LZ1DPN/CWTRX0to50MHz-v1/arduino uno.jpg

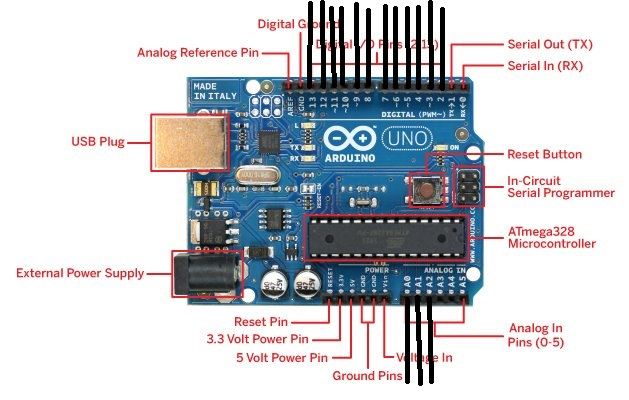
arduino uno.jpg
