LZ1DPN/CWTRX0to50MHz-v1/forty-9er.pdf

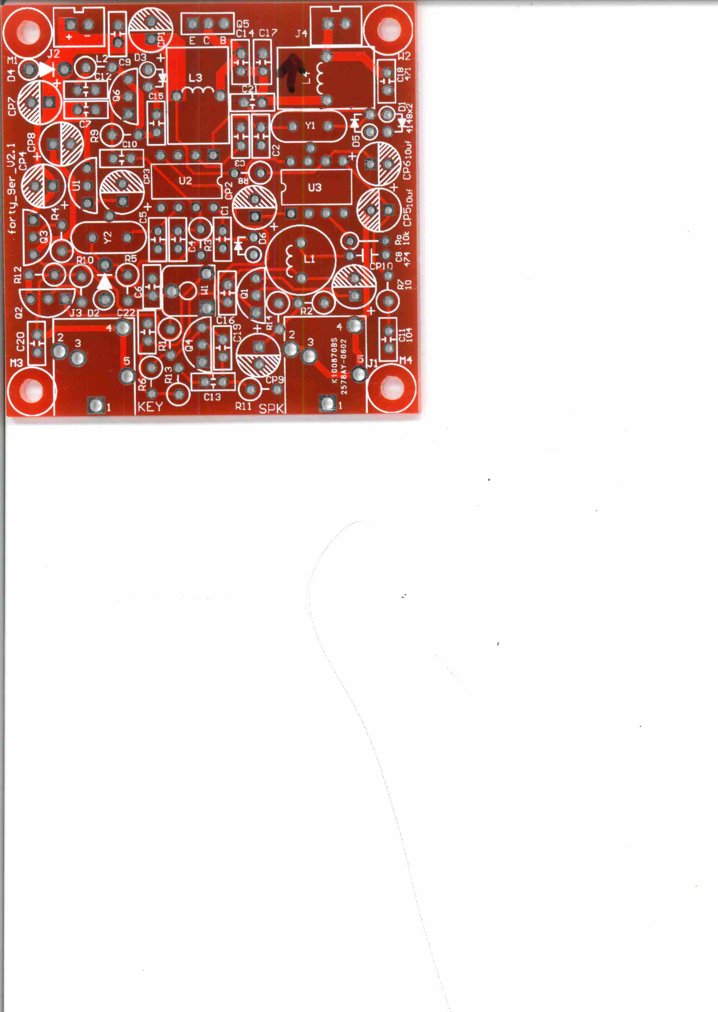
[picture p7: page 1]
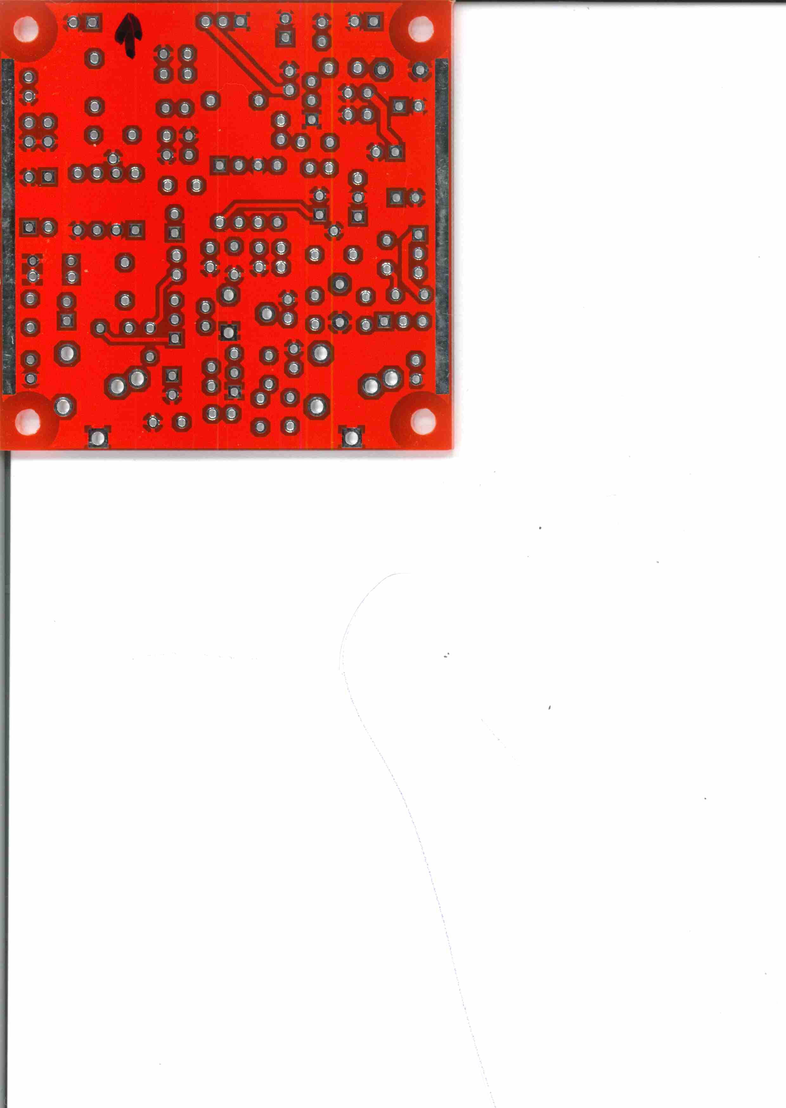
[picture p8: page 2]
