LZ1DPN/CWTRX0to50MHz-v1/74dB_Gain_with_LM386_JF1OZL.gif

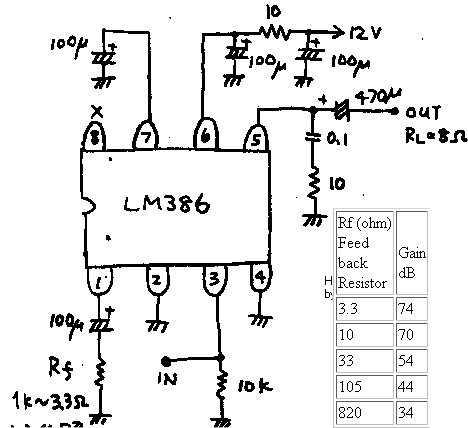
74dB_Gain_with_LM386_JF1OZL.gif
