LZ1DPN/CWTRX0to50MHz-v1/circuitDDS-Arduino-AD-LCD.png

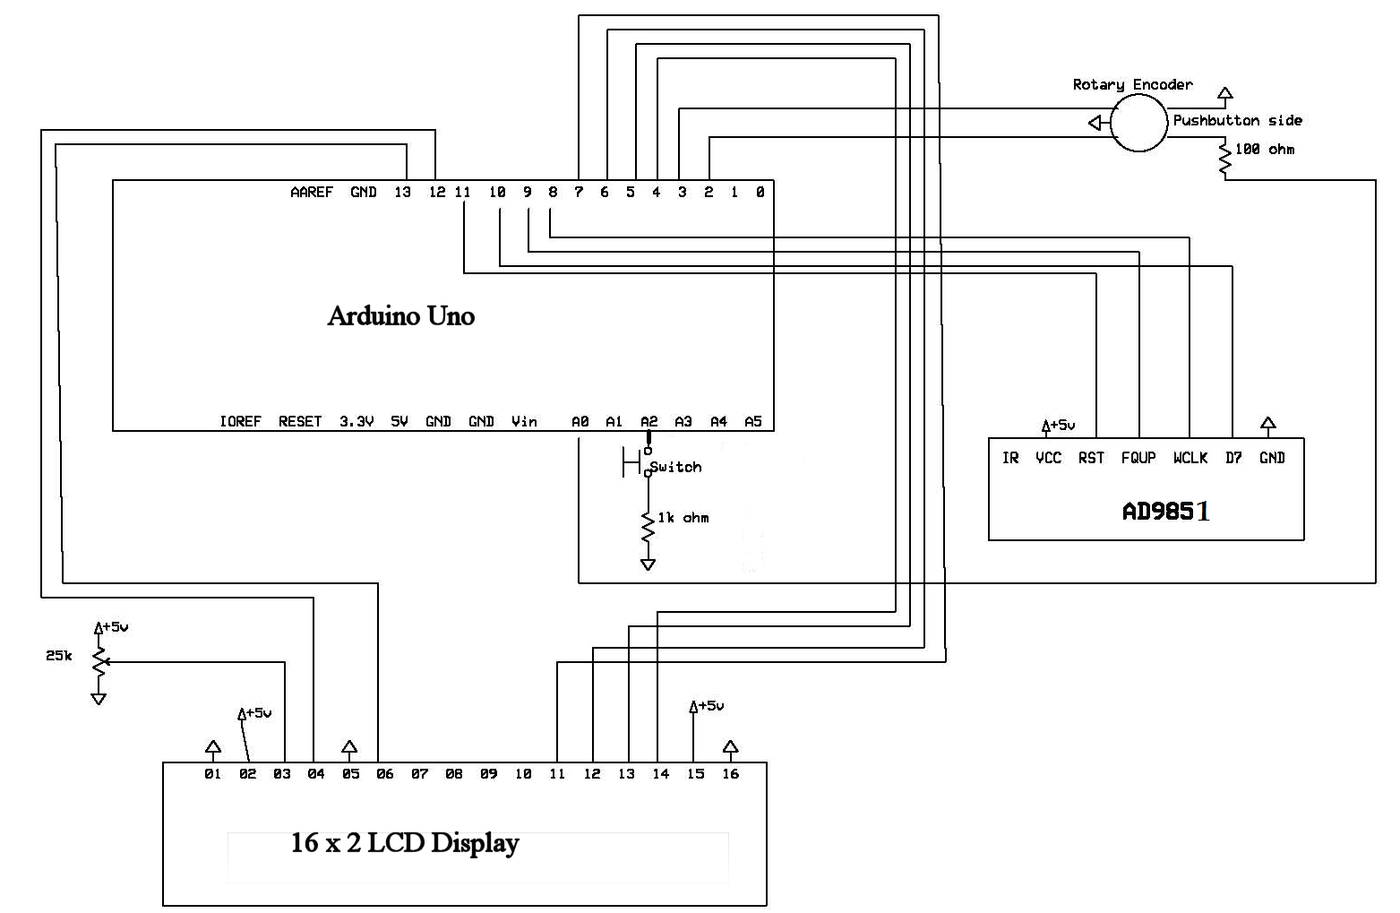
circuitDDS-Arduino-AD-LCD.png
