LZ1DPN/CWTRX0to50MHz-v1/dc-receiver-last.png

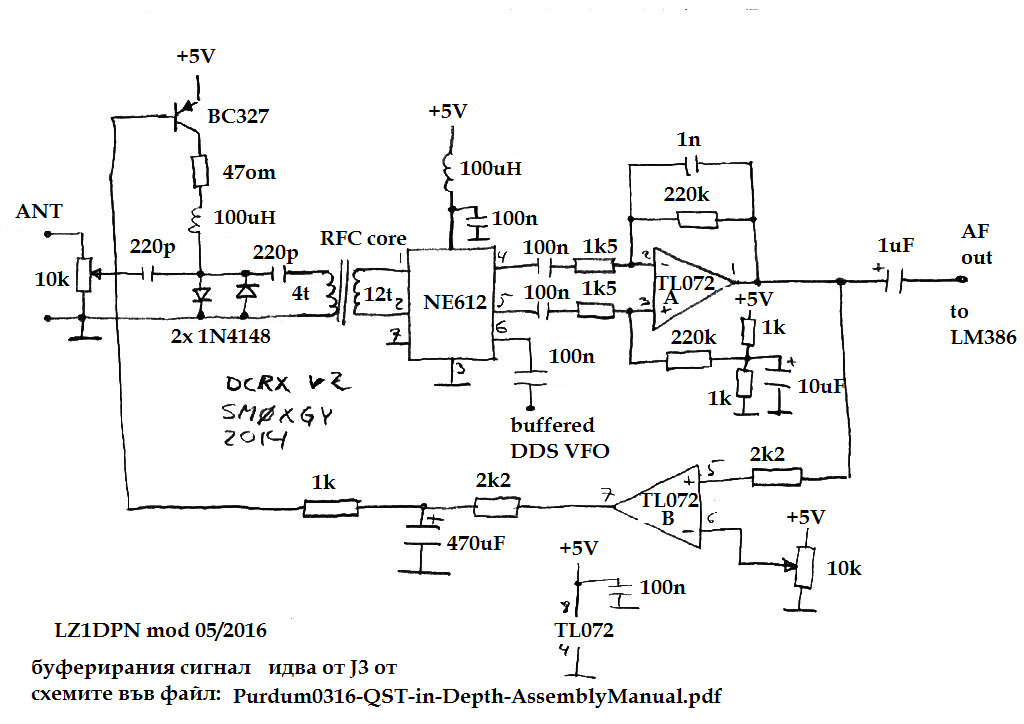
dc-receiver-last.png
