LZ1DPN/CWTRX0to50MHz-v1/dcrx_rf_sch.jpg

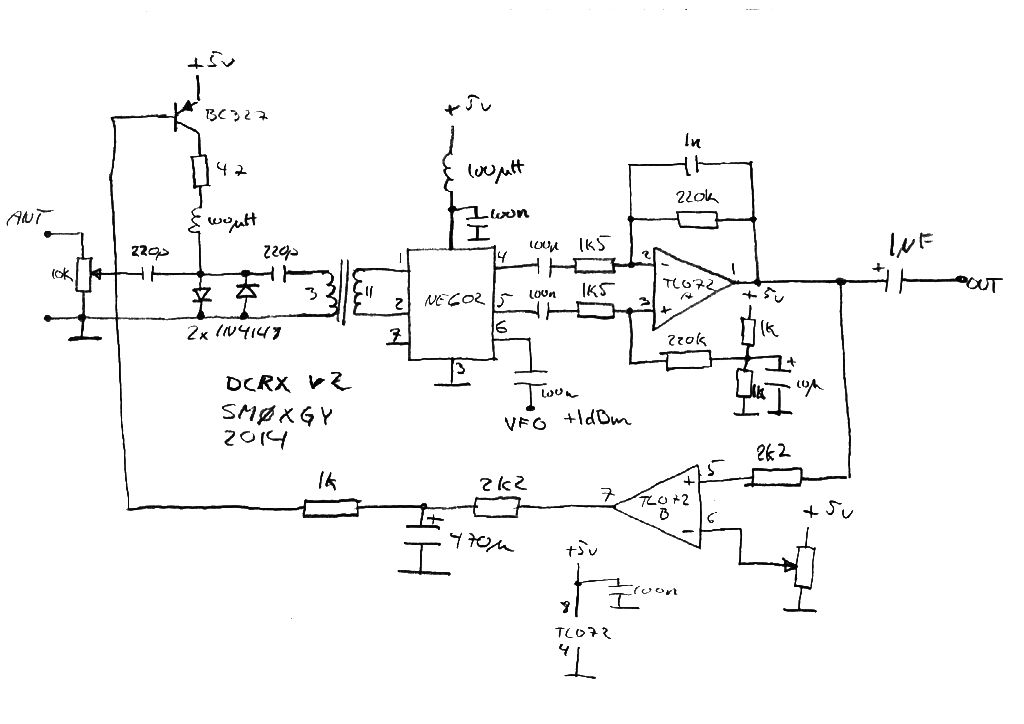
dcrx_rf_sch.jpg
