LZ1DPN/CWTRX0to50MHz-v1/DDSbuffer-and-PowerSupplay.png

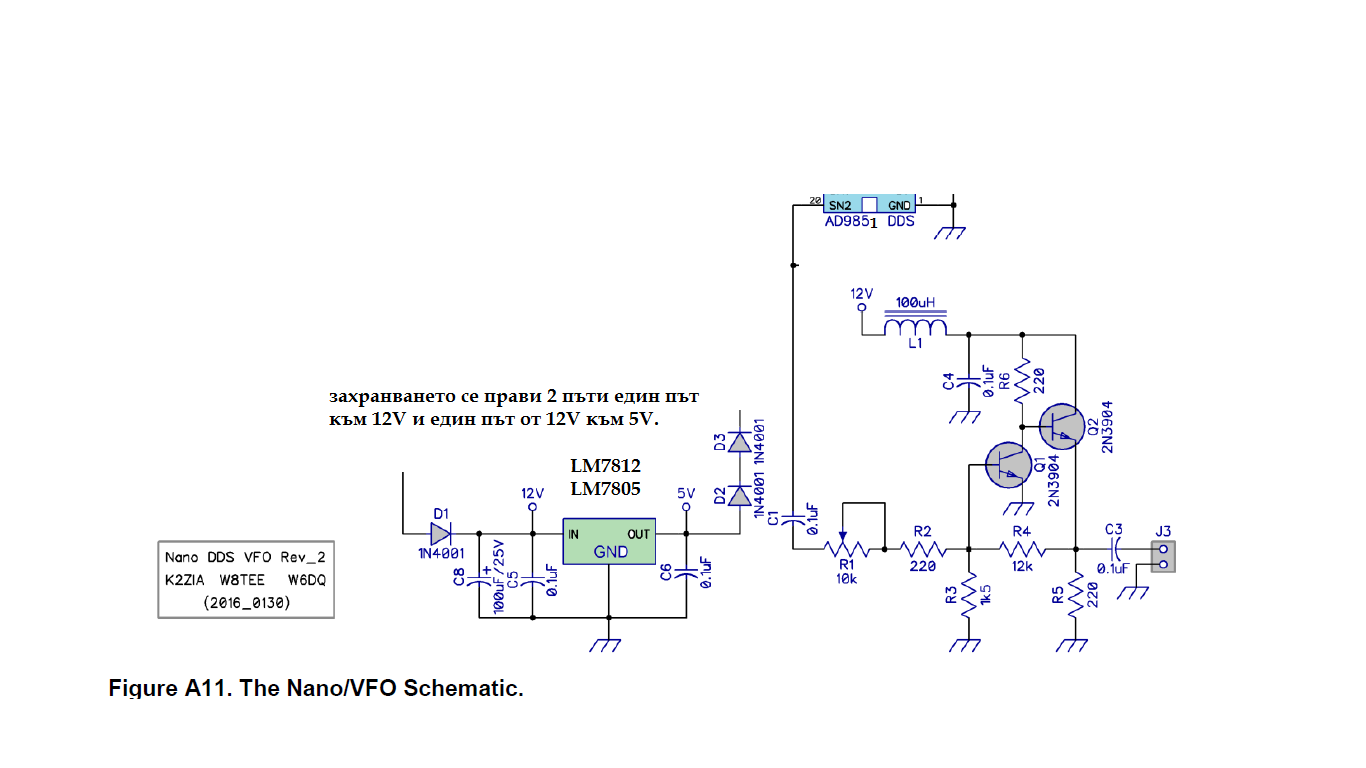
DDSbuffer-and-PowerSupplay.png
