LZ1DPN/CWTRX0to50MHz-v1/LM386ampschematicfinal1.jpg

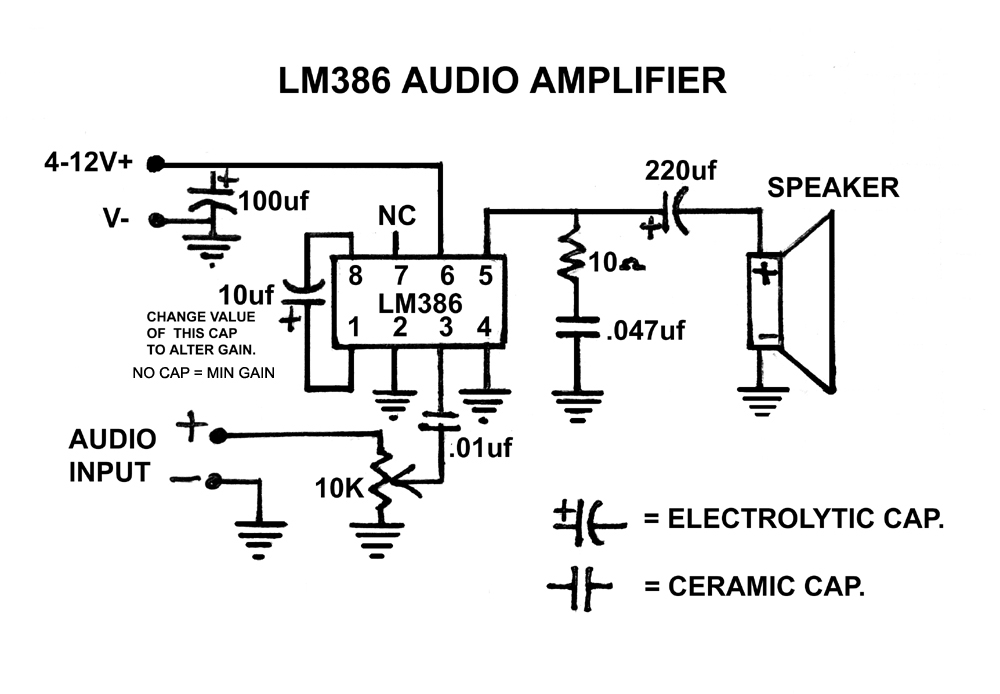
LM386ampschematicfinal1.jpg
