LZ1DPN/CWTRX0to50MHz-v1/relay-control.png

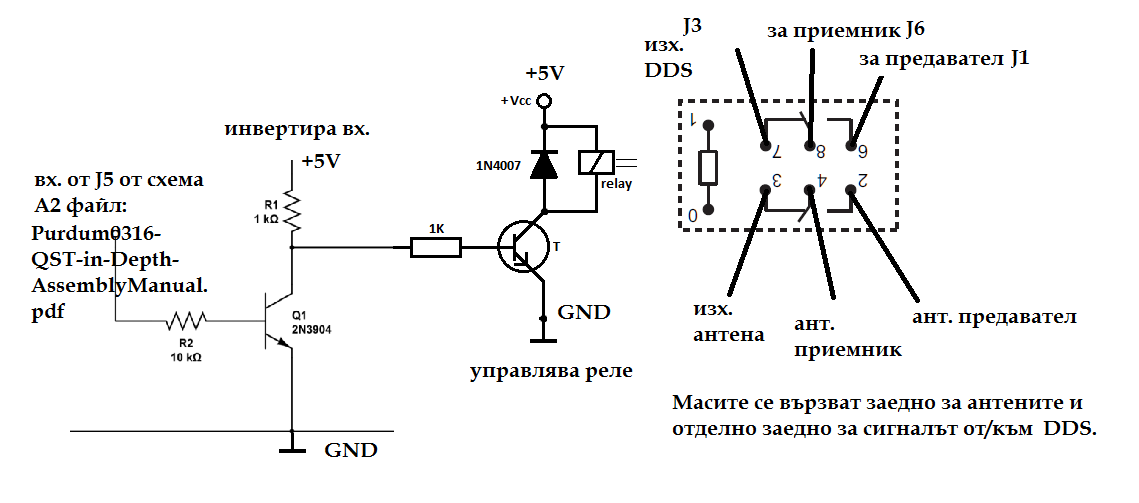
relay-control.png
