LZ1DPN/CWTRX0to50MHz-v1/dds-vfo-assembly-manual-rev2.pdf

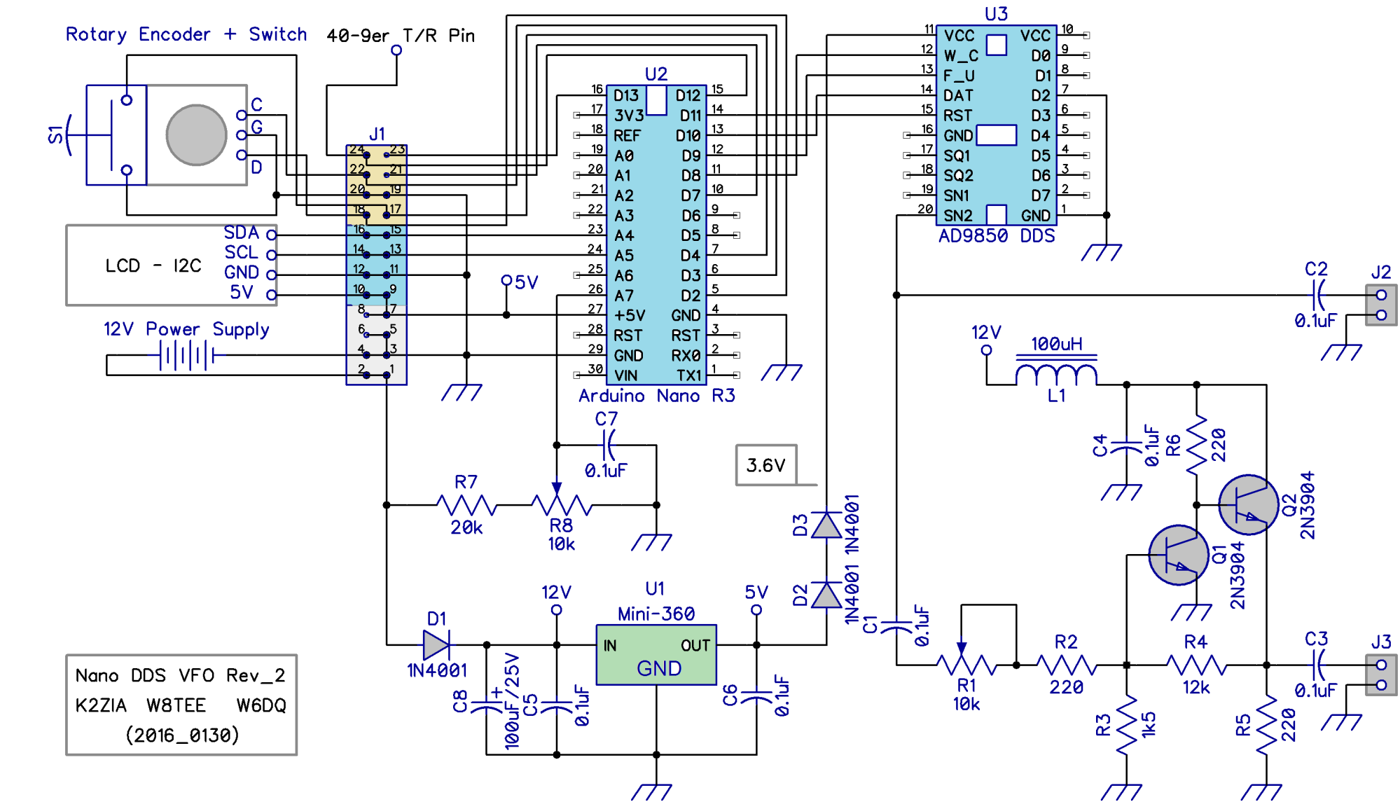
[picture p17: page 1]

Nano DDS VFO Rev_2 Assembly Manual
Farrukh Zia, K2ZIA, 2016_0130
Featured in ARRL QST March 2016 Issue
Nano DDS VFO is a modification of the original VFO design in Arduino™ Projects for Amateur Radio by Dr. Jack Purdum and Dennis Kidder

Schematic Diagram:

R2,R3,R4,R7 are ¼ Watt; R5,R6 are 220 Ohm ½ Watt (or two 470 Ohm ¼ Watt in parallel)

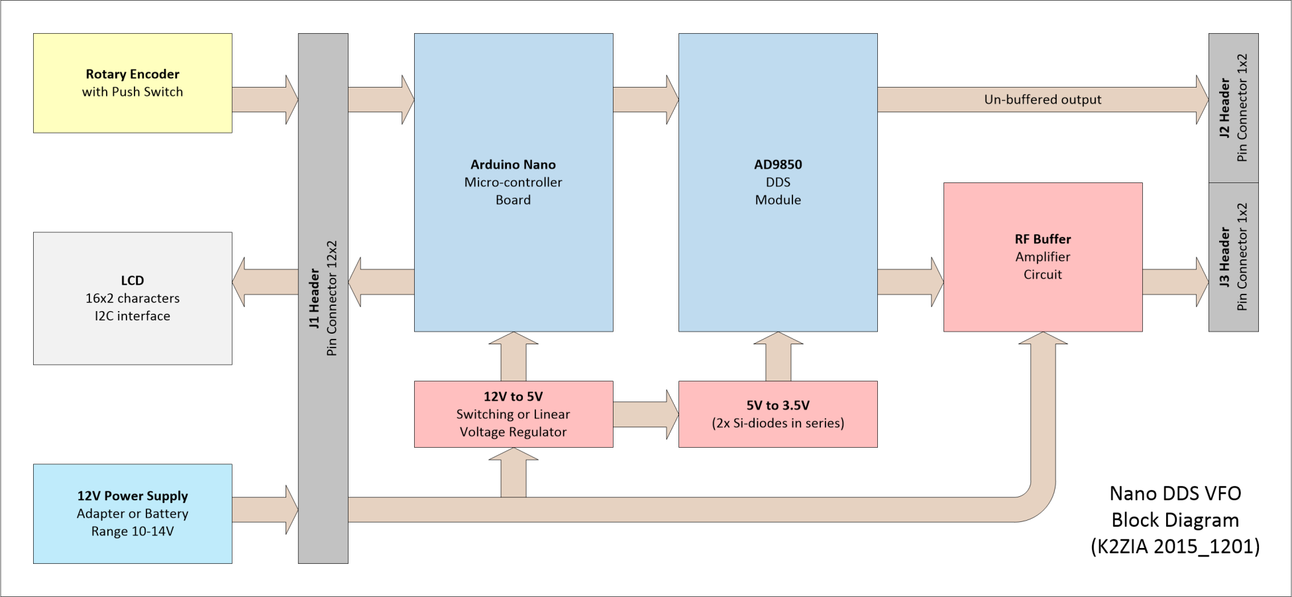
[picture p18: figure]
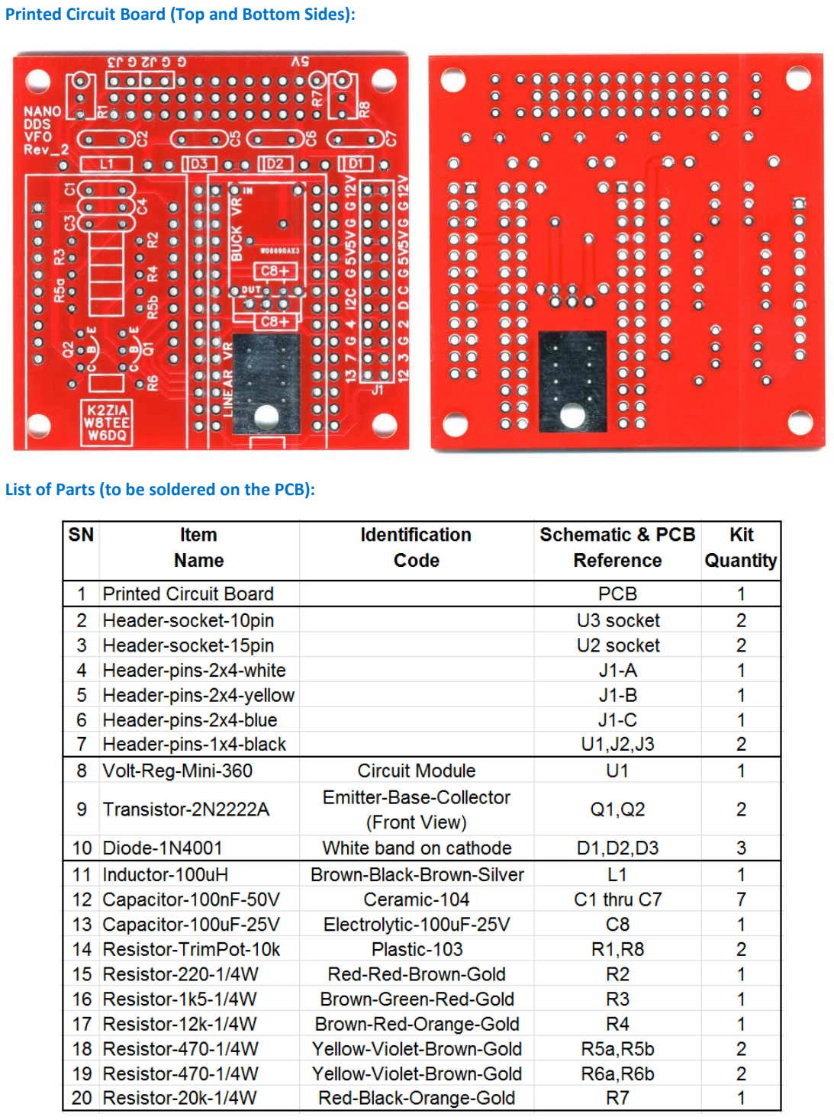
[picture p19: page 3]

Printed Circuit Board (Top and Bottom Sides):

List of Parts (to be soldered on the PCB):

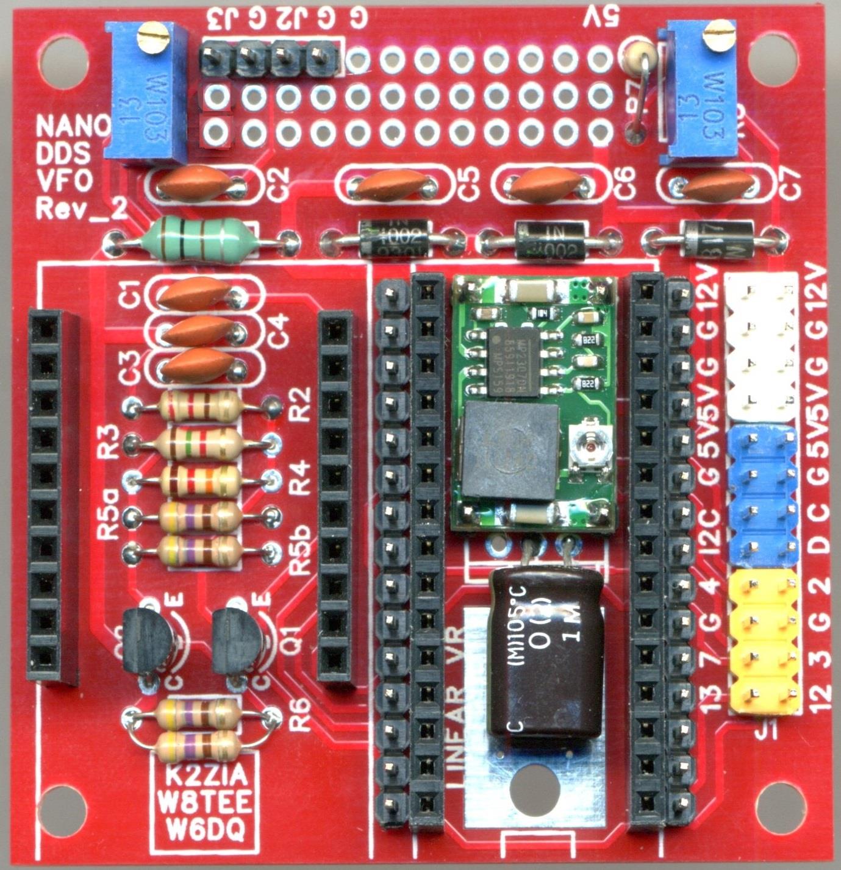
[picture p20: page 4]

Finished PC Board (See suggested soldering sequence and tips below, BEFORE soldering any components):

The two rows of 1x15 header pins as seen in the above picture on either side of the two 1x15 header sockets, are optional (for future expansion of Nano control functions) and are not required for DDS VFO operation.

Suggested Soldering Sequence and Tips:

a) Tip: The PCB has space for either a linear LM7805 voltage regulator, or a Mini-360 Buck voltage regulator circuit module. Use a Mini-360 circuit module for much greater power consumption efficiency.

The Mini-360 circuit module needs to be installed as close to the top surface of the VFO PCB as possible but without touching the PCB top surface, to allow sufficient gap and clearance between the Mini-360 circuit module and the Nano micro-controller module, which will sit right above the Mini-360.

Carefully break off Black 1x4 header pins into four individual header pins (to be used as stand-off legs for the Mini-360 module). Solder these leg pins to the four corner holes on the Mini-360 module, while making sure the legs are perpendicular to the module surface. Install the Mini-360 module on to the VFO PCB in the correct orientation. Module’s IN+ and OUT+ legs should be in VFO PCB’s IN and OUT holes respectively. Solder the Mini-360 module legs from bottom side of VFO PCB.

b) Solder J1 header pins – White 2x4 [Power], Blue 2x4 [I2C Bus], Yellow 2x4 [Control]
c) Solder G-J2-G-J3 header pins – Black 1x4
d) Solder a radial lead 100uF / 25V electrolytic capacitor (C8) after bending its leads and laying it on its side as seen in the above picture. Correct polarity must be observed.
e) Solder all ceramic caps (C1 through C7).
f) Solder all fixed resistors according to schematic diagram and the PCB pictures shown above.

Tip: Resistors R5 and R6 each consist of two 470 ohm, ¼ Watt resistors in parallel, providing an effective value of 235 ohm, ½ Watt. It is OK to use single 220 ohm, ½ Watt resistors for R5 and R6 as an alternative.

g) Solder the two 10k ohm trimmer potentiometers. Observe correct orientation as shown in above picture.
h) Solder inductor choke L1.
i) Solder the three rectifier diodes (D1, D2, D3) while observing correct polarity.
j) Solder the two transistors Q1 and Q2 while observing correct lead orientation (Emitter-Base-Collector, as seen from front (labeled) side of the transistor).
k) Solder the two 1x10 female header sockets for installing the AD9850 DDS module.
l) Solder the two 1x15 female header sockets for installing the Nano micro-controller module.

After the DDS VFO board is fully populated, but BEFORE the Nano and DDS modules are plugged into their socket headers, the output of the Mini-360 adjustable buck regulator must be adjusted to 5.0V. For this adjustment, connect 12V DC power to J1 pins 2 and 4 using suitable Dupont jumper wires, connect DMM probes to the 5V and G (Ground) pads near one side edge of the VFO PCB (see picture above). Slowly rotate the tiny round trimmer potentiometer on the Mini-360 module with a jeweler’s Philips screw driver until you measure almost exactly 5.0 V on the DMM.

m) Install the AD9850 DDS module and the Nano micro-controller module in corresponding sockets while observing correct orientation.

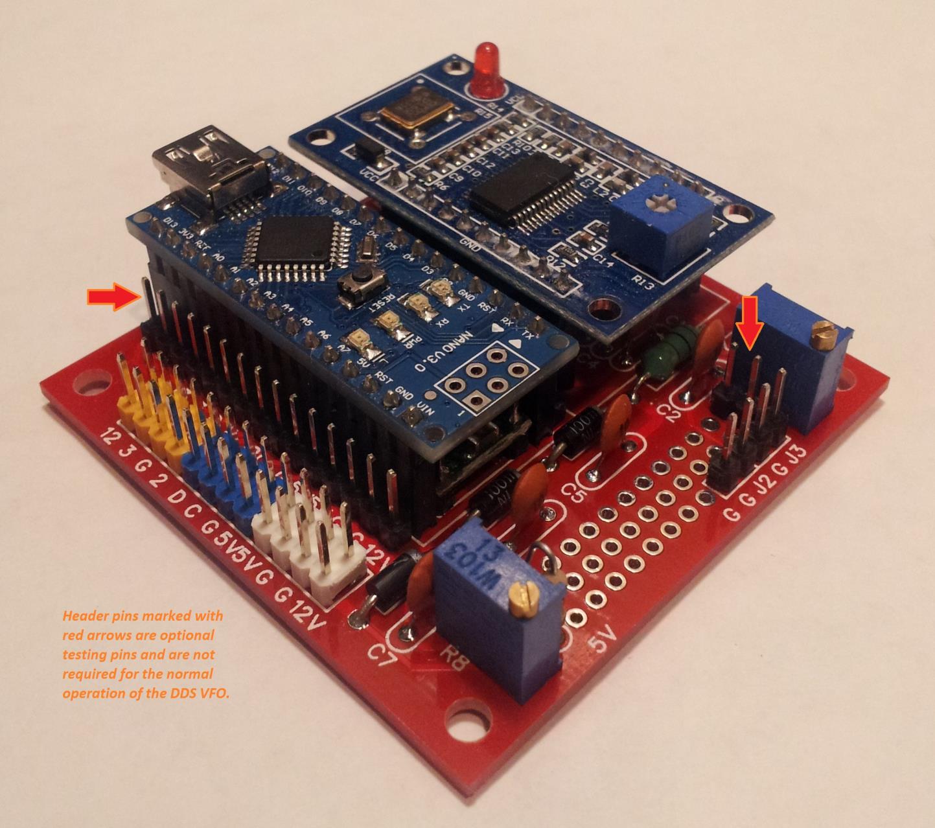
[picture p21: figure]

n) Attach a suitable rotary encoder with built-in push switch to J1 control pins (Yellow) according to the schematic diagram.
o) Attach a 16x2 LCD module with I2C interface to the J1 I2C bus pins (Blue) according to the schematic diagram.
p) Attach a suitable 12V DC, 2A regulated power supply (or battery) (through an optional On/Off power switch to J1 power pins (12V-G) (White).

The DDS VFO board is now ready for firmware (software) installation and testing.

Please see Firmware Instructions for Arduino IDE.

<Instructions for connecting the external components, I2C LCD, Rotary Encoder, Power Supply, to be added here>
